kbeckmann/TR-9/kicad/Mainboard/Mainboard.kicad_pcb

## KiCad design kicad/Mainboard/Mainboard.kicad_pcb (2020-09-24)

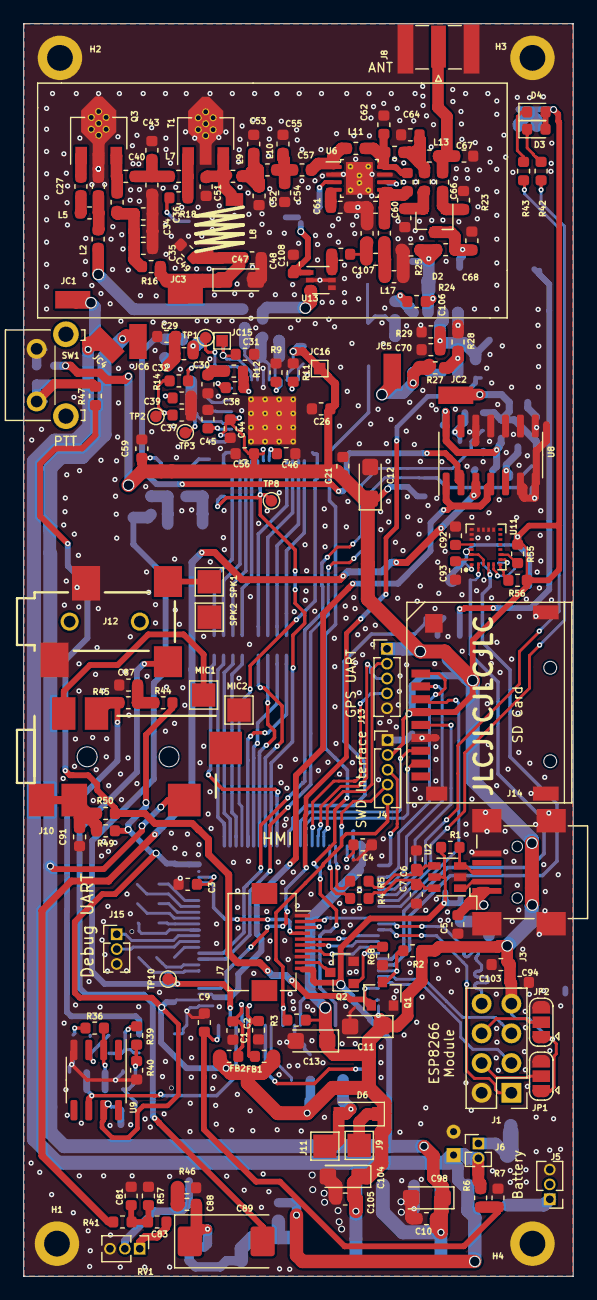
[picture p1: board Mainboard.kicad_pcb from above]

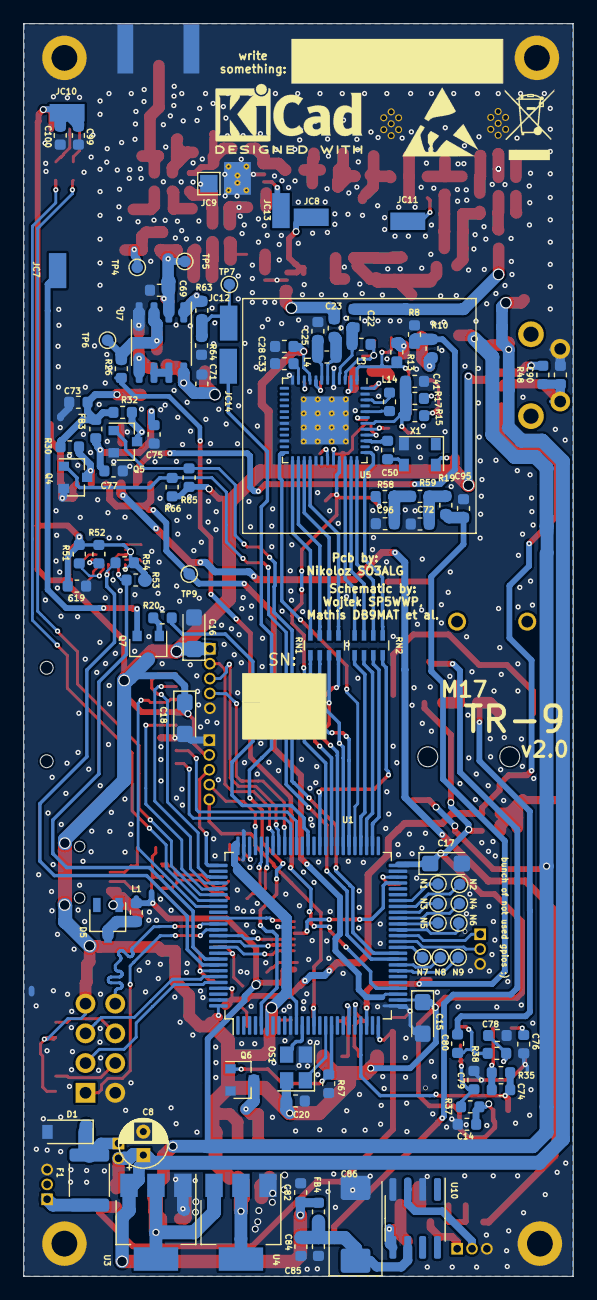
[picture p2: board Mainboard.kicad_pcb from below]

Board: 2 copper layers, 47.0 x 107.1 mm, 279 parts (105 on the bottom side), 177 nets.

Parts:
C1, C2, C10, C14, C19, C30, C32, C33, C45, C46, C77, C85, C90, C91, C93, C100, C103, C105: 100n; C_0603_1608Metric
C3, C4: 2u2; C_0603_1608Metric
C5, C9, C20, C26, C28, C31, C44, C56, C59, C70, C71, C73, C82, C92, C94: 10n; C_0603_1608Metric
C6, C7: 47p; C_0603_1608Metric
C8: 22u; CP_Radial_D4.0mm_P2.00mm
C11, C12, C13, C15, C16, C17, C18, C98, C104: 22u/TA; CP_EIA-3216-18_Kemet-A
C21, C27, C40: 220p; C_0603_1608Metric
C22, C42, C43, C51, C55, C106: 10p; C_0603_1608Metric
C23: 4p7; C_0603_1608Metric
C24, C25: 6p8; C_0603_1608Metric
C29: 2n2; C_0603_1608Metric
C34, C75, C80, C84, C99: 1u; C_0603_1608Metric
C35, C41, C68, C69: 1n; C_0603_1608Metric
C36, C49: 100p; C_0603_1608Metric
C37: 470p; C_0603_1608Metric
C38, C108: 22n; C_0603_1608Metric
C39, C81: 15n; C_0603_1608Metric
C47: 1u/TA; CP_EIA-3216-18_Kemet-A
C48, C57, C58, C63: 1000p; C_0603_1608Metric
C50: 22p; C_0603_1608Metric
C52, C62: 7p; C_0603_1608Metric
C53: 12p; C_0603_1608Metric
C54: 2p; C_0603_1608Metric
C60: 6p2; C_0603_1608Metric
C61: 33p; C_0603_1608Metric
C64, C67: 9p1; C_0603_1608Metric
C65, C66: 0.5p; C_0603_1608Metric
C72, C95, C96: 1n5; C_0603_1608Metric
C74, C88: 47n; C_0603_1608Metric
C76: 22u; C_0603_1608Metric
C78: 6n8; C_0603_1608Metric
C79, C87: 10u; C_0603_1608Metric
C83: 220n; C_0603_1608Metric
C86, C89: 220u; CP_EIA-7343-31_Kemet-D
C97: 8p2; C_0603_1608Metric
C107: 5p1; C_0603_1608Metric
D1, D6: CGRM4007-G; D_SOD-123
D2: BAS70-05; SOT-23
D3: RED; D_0603_1608Metric
D4: GREEN; D_0603_1608Metric
D5: PMEG4005ET.215
F1: 2A; Fuse_1812_4532Metric
FB1, FB2, FB3, FB4: TBD; L_0603_1608Metric
H1, H2, H3, H4: MountingHole_Pad; MountingHole_2.2mm_M2_ISO14580_Pad
J1: ESP8266 module; PinHeader_2x04_P2.54mm_Vertical
J3: USB_OTG; USB_Mini-B_Wuerth_65100516121_Horizontal
J4: SWD; PinHeader_1x05_P1.27mm_Vertical
J5: BATT; PinHeader_1x03_P1.27mm_Vertical
J6: POT_PWR_SW; PinHeader_1x02_P1.27mm_Vertical
J7: Conn_01x10; Hirose_FH12-10S-0.5SH_1x10-1MP_P0.50mm_Horizontal
J8: Antenna; SMA_Samtec_SMA-J-P-X-ST-EM1_EdgeMount
J9: VIB1; TestPoint_Pad_2.0x2.0mm
J10: MIC_EXT
J11: VIB2; TestPoint_Pad_2.0x2.0mm
J12: SPK_EXT
J13: GPS_CONN; PinHeader_1x05_P1.27mm_Vertical
J14: Micro_SD_Card; microSD
J15: DBG_CONN; PinHeader_1x03_P1.27mm_Vertical
JC1, JC2, JC3, JC4, JC6: Batt; Pad1x3
JC5: 5V; Pad1x3
JC7: LNA_1; Pad1x3
JC8: LNA_2; Pad1x3
JC9: TRX_SW_PWR_1; TestPoint_Pad_1.5x1.5mm
JC10: TRX_SW_PWR_2; Pad1x3
JC11, JC12: BIAS; Pad1x3
JC13, JC14: TRX_SW; Pad1x3
JC15, JC16: 3,3V; TestPoint_Pad_1.0x1.0mm
JP1: GPIO0; SolderJumper-3_P1.3mm_Open_RoundedPad1.0x1.5mm
JP2: GPIO2; SolderJumper-3_P1.3mm_Open_RoundedPad1.0x1.5mm
L1: 100MHz; L_0603_1608Metric
L2: 20n; L_0603_1608Metric
L3: 15n; L_0603_1608Metric
L4: 27n; L_0603_1608Metric
L5: 22n; L_0603_1608Metric
L6: 68nH; L_0603_1608Metric
L7: 2.7nH; L_0603_1608Metric
L8: 8/0.5/2.4; RF_Coil_v2_mirrored
L9, L10: 1nH; L_0603_1608Metric
L11: 100nH; L_0603_1608Metric
L12, L13: 15nH; L_0603_1608Metric
L14: DNP; L_0603_1608Metric
L16: 13nH; L_0603_1608Metric
L17: 20nH; L_0603_1608Metric
MIC1: Microphone pin 1; TestPoint_Pad_2.0x2.0mm
MIC2: Microphone pin 2; TestPoint_Pad_2.0x2.0mm
N1, N2, N3, N4, N5, N7, N8, N9: TP2; TestPoint_Pad_D1.0mm
N6: TP1; TestPoint_Pad_D1.0mm
OS1: ECS-3225MV-160-CN-TR; ECS-3225-MV-160-CN-TR
Q1, Q2, Q4, Q5, Q6: BSS138; SOT-23
Q3: BGA6589
Q7: FDV304P; SOT-23
R1: 1k5; R_0603_1608Metric
R2, R3, R25, R26, R29, R39, R48, R49, R51, R52, R55, R56: 10k; R_0603_1608Metric
R4, R5: 27; R_0603_1608Metric
R6: 9k1; R_0603_1608Metric
R7, R44: 1k; R_0603_1608Metric
R8, R41, R65, R66, R67, R68: 22k; R_0603_1608Metric
R9: 1k1; R_0603_1608Metric
R10, R13, R24, R27, R28, R30, R32, R37, R40: 47k; R_0603_1608Metric
R11: 3k6; R_0603_1608Metric
R12: 3R9; R_0603_1608Metric
R14: 100; R_0603_1608Metric
R15: 560; R_0603_1608Metric
R16: 51; R_0603_1608Metric
R17: 270; R_0603_1608Metric
R18, R38, R53, R54: 4k7; R_0603_1608Metric
R19, R58, R59, R63, R64: 5k6; R_0603_1608Metric
R20: ?; R_0603_1608Metric
R22, R23: 33k; R_0603_1608Metric
R35: 820; R_0603_1608Metric
R36: 22; R_0603_1608Metric
R42, R43, R47, R50: 470; R_0603_1608Metric
R45: 3k9; R_0603_1608Metric
R46: 10; R_0603_1608Metric
R57: 2k1; R_0603_1608Metric
RN1, RN2: 4 x 1k ISOLATED; R_Array_Concave_4x0603
RV1: 50k/log; PinHeader_1x03_P1.27mm_Vertical
SPK1: Speaker pin 1; TestPoint_Pad_2.0x2.0mm
SPK2: Speaker pin 2; TestPoint_Pad_2.0x2.0mm
SW1: INT_PTT_SW; SW_Tactile_SKHH_Angled
T1: AFT05MS004NT1
TP1, TP2, TP3, TP4, TP5, TP6, TP7, TP8, TP9, TP10: TestPoint_Probe; TestPoint_Pad_D1.0mm
U1: STM32F777VIT; LQFP-100_14x14mm_P0.5mm
U2: USBLC6-2SC6; SOT-23-6
U3: LD1117S50TR_SOT223; SOT-223-3_TabPin2
U4: LD1117S33TR_SOT223; SOT-223-3_TabPin2
U5: ADF7021; LFCSP-48-1EP_7x7mm_P0.5mm_EP4.1x4.1mm_ThermalVias
U6: HMC546MS8GETR
U7: LM2904A; SO-8_3.9x4.9mm_P1.27mm
U8: HEF4066B; SOIC-14_3.9x8.7mm_P1.27mm
U9: OPA340UA; SO-8_3.9x4.9mm_P1.27mm
U10: LM386; SOIC-8_3.9x4.9mm_P1.27mm
U11: LSM9DS1; LGA-24L_3x3.5mm_P0.43mm
U13: BGA2874; SOT-363_SC-70-6
X1: 12.288MHz; ECS-TXO-3225

Connections:
+3V3: C11.1, C12.1, C13.1, C14.1, C15.1, C16.1, C17.1, C18.1, C19.1, C20.2, C21.1, C26.1, C28.1, C31.1, C44.1, C56.1, C59.1, C94.1, C99.1, C100.1, C103.1, C104.1, C105.1, D3.2, D4.2, D6.1, FB1.2, FB2.2, J1.7, J4.2, J7.3, J9.1, J13.1, J14.4, JC9.1, JC10.1, JC15.1, JC16.1, JP1.1, JP2.1, L3.1, OS1.4, Q7.3, R2.2, R3.1, R37.2, R44.2, R48.1, R49.1, R51.1, R52.1, R53.1, R54.1, R55.1, R56.1, R65.2, R66.2, U1.6, U1.11, U1.27, U1.50, U1.75, U1.100, U4.2, U5.3, U5.9, U5.32, U5.40, U5.43, U6.6, U9.7, U11.1, U11.3, U11.22, U11.23, X1.4
+5V: C10.1, C71.1, C98.1, J7.10, J10.1, JC5.1, JC6.1, L1.1, R1.1, R27.2, U2.5, U3.2, U4.3, U7.8
+BATT: C8.1, C47.1, C48.2, C49.2, C73.1, C82.1, FB3.1, FB4.1, J6.2, JC1.1, JC2.1, JC3.1, JC4.1, L8.1, R6.1, R16.2, R30.1, R32.1, U3.3
ADC1_0: C74.2, R35.2, U1.22, U9.6
ADC2_3: C9.2, R6.2, R7.1, U1.25
ADC3_1: C95.2, R19.1, TP10.1, U1.23
ADF_CE: U1.55, U5.24
ADF_MUXOUT: RN2.8, U1.61
ADF_SCLK: RN1.8, U1.59
ADF_SDATA: RN1.6, U1.57
ADF_SLE: RN1.5, U1.56
ADF_SREAD: RN1.7, U1.58
ADF_SWD: R58.2, TP8.1, U1.60, U5.33
AUDIO_DAC: TP9.1, U1.28, U8.1, U8.4
BATT_ANALOG: C75.1, C77.1, FB3.2, U8.14
BLIGHT_CTRL: Q2.1, R68.1, U1.91
BOOT0: Q1.3, R2.1, U1.94
FM_MOD: R8.2, R10.1, U8.2
FM_MOD_SEL: Q5.1, R65.1, U1.35
GND: C1.2, C2.2, C3.1, C4.1, C5.1, C6.1, C7.1, C8.2, C9.1, C10.2, C11.2, C12.2, C13.2, C14.2, C15.2, C16.2, C17.2, C18.2, C19.2, C20.1, C21.2, C24.2, C25.2, C26.2, C28.2, C29.1, C30.2, C31.2, C33.2, C34.2, C35.2, C36.2, C37.2, C39.2, C41.2, C42.2, C43.2, C44.2, C45.2, C46.1, C47.2, C48.1, C49.1, C51.2, C52.1, C53.2, C54.1, C55.2, C56.2, C59.2, C60.1, C61.2, C62.1, C64.1, C67.1, C68.2, C69.2, C70.2, C71.2, C72.1, C73.2, C75.2, C76.2, C77.2, C78.2, C79.1, C81.2, C82.2, C84.2, C85.2, C86.2, C87.1, C90.1, C91.1, C92.2, C93.2, C94.2, C95.1, C96.1, C98.2, C99.2, C100.2, C103.2, C104.2, C105.2, C108.2, D1.2, H1.1, H2.1, H3.1, H4.1, J1.2, J3.5, J3.6, J4.1, J5.3, J7.1, J7.8, J8.2, J12.2, J13.5, J14.6, J14.9, J15.3, JP1.3, JP2.3, L16.2, L17.2, MIC2.1, OS1.2, Q1.2, Q2.2, Q3.2, Q4.2, Q5.2, Q6.2, R7.2, R8.1, R9.2, R11.2, R22.1, R23.1, R25.1, R28.1, R29.1, R40.1, R46.1, R57.2, R64.2, R67.2, R68.2, RV1.3, SPK2.1, SW1.2, T1.S, U1.10, U1.19, U1.26, U1.49, U1.74, U1.99, U2.2, U3.1, U4.1, U5.5, U5.12, U5.19, U5.22, U5.29, U5.45, U5.47, U5.49, U6.2, U6.7, U6.EP, U7.4, U8.6, U8.7, U8.8, U8.9, U8.10, U8.11, U8.12, U9.4, U10.2, U10.4, U11.14, U11.15, U11.16, U11.17, U11.18, U11.19, U11.20, U13.2, U13.4, U13.5, X1.2
GPS_EN: J13.4, U1.67
I2C1_SCL: R53.2, U1.92, U11.2
I2C1_SDA: R54.2, U1.93, U11.4
LED_GRN: R43.2, U1.81
LED_RED: R42.2, U1.82
LNA_On: R20.1, U1.63
MIC_AMP_IN: C80.1, J10.2, R45.1
NRST: J4.5, R3.2, U1.14
unnamed: C3.2, U1.48
unnamed: C4.2, U1.73
unnamed: C5.2, D5.2, J3.1
unnamed: C6.2, R5.2, U2.4
unnamed: C7.2, R4.2, U2.6
unnamed: C22.2, L3.2, U5.4
unnamed: C23.2, L4.1, U5.6
unnamed: C24.1, L2.2, L5.1
unnamed: C25.1, L4.2, U5.7
unnamed: C27.1, Q3.3
unnamed: C27.2, L5.2
unnamed: C29.2, C32.2, R10.2
unnamed: C30.1, R12.2
unnamed: C32.1, R13.2
unnamed: C33.1, U5.11
unnamed: C34.1, C35.1, C36.1, L6.1, R16.1
unnamed: C37.1, R14.1, R15.2, TP2.1
unnamed: C38.1, U5.48
unnamed: C38.2, R12.1, U5.2
unnamed: C39.1, R17.2
unnamed: C40.1, C42.1, C43.1, L7.1
unnamed: C40.2, L6.2, Q3.1
unnamed: C41.1, R15.1, R17.1, TP3.1, U5.42
unnamed: C45.1, U5.41
unnamed: C46.2, U5.31
unnamed: C50.1, U5.39
unnamed: C50.2, X1.3
unnamed: C51.1, L8.2, L9.1, T1.D
unnamed: C52.2, C53.1, L9.2, L10.1
unnamed: C54.2, C55.1, C57.2, L10.2
unnamed: C57.1, L11.1, U6.1
unnamed: C58.1, C60.2, L12.1, U6.5
unnamed: C61.1, U6.4
unnamed: C62.2, C63.2, L11.2, L12.2, U6.8
unnamed: C63.1, C64.2, C65.2, L13.1
unnamed: C65.1, D2.2, R22.2
unnamed: C66.1, D2.1, R23.2
unnamed: C66.2, C67.2, J8.1, L13.2
unnamed: C68.1, D2.3, R24.2, TP4.1
unnamed: C70.1, R26.1, R29.2, TP6.1, U7.3
unnamed: C72.2, R19.2, R59.1
unnamed: C74.1, R35.1, R36.1, U9.2
unnamed: C76.1, R36.2
unnamed: C78.1, R38.2, U9.3
unnamed: C79.2, R37.1, R39.2, R40.2
unnamed: C80.2, R38.1, R39.1
unnamed: C81.1, C83.1, R41.1, R57.1
unnamed: C83.2, RV1.1
unnamed: C84.1, C85.1, C86.1, FB4.2, U10.6
unnamed: C87.2, R44.1, R45.2
unnamed: C88.1, R46.2
unnamed: C88.2, C89.1, U10.5
unnamed: C89.2, J12.1
unnamed: C90.2, R47.1, R48.2, SW1.1
unnamed: C91.2, J10.3, R49.2, R50.2
unnamed: C92.1, U11.21
unnamed: C93.1, U11.24
unnamed: C96.2, R58.1, R59.2
unnamed: C97.1, U13.6
unnamed: C106.1, R63.1, U7.1
unnamed: C69.1, C106.2, R24.1, R25.2, TP5.1, U7.2
unnamed: C97.2, C107.1, L16.1
unnamed: C58.2, C107.2, L17.1
unnamed: C108.1, JC7.1, JC8.1, Q7.2, U13.1
unnamed: D1.1, F1.2, J6.1
unnamed: D3.1, R42.1
unnamed: D4.1, R43.1
unnamed: D5.1, L1.2
unnamed: D6.2, J11.1, Q6.3
unnamed: F1.1, J5.1
unnamed: J1.4, JP1.2
unnamed: J1.6, JP2.2
unnamed: J3.2, U2.1
unnamed: J3.3, R1.2, U2.3
unnamed: J10.5, MIC1.1
unnamed: J12.3, SPK1.1
unnamed: JC11.1, JC12.1, R18.1, R63.2, R64.1, TP7.1
unnamed: L14.1, U5.46
unnamed: L14.2, U5.44
unnamed: N1.1, U1.44
unnamed: N2.1, U1.43
unnamed: N3.1, U1.42
unnamed: N4.1, U1.41
unnamed: N5.1, U1.40
unnamed: N6.1, U1.39
unnamed: N7.1, U1.36
unnamed: N8.1, U1.33
unnamed: N9.1, U1.32
unnamed: OS1.3, U1.12
unnamed: Q4.3, R30.2, U8.5
unnamed: Q5.3, R32.2, U8.13
unnamed: Q7.1, R20.2
unnamed: R9.1, U5.8
unnamed: R11.1, U5.10
unnamed: R13.1, R14.2, TP1.1, U5.1
unnamed: R27.1, R28.2, U7.5
unnamed: R51.2, U11.5
unnamed: R52.2, U11.7
unnamed: R55.2, U11.8
unnamed: R56.2, U11.6
unnamed: RN1.1, U5.28
unnamed: RN1.2, U5.27
unnamed: RN1.3, U5.26
unnamed: RN1.4, U5.25
unnamed: RN2.1, U5.37
unnamed: RN2.2, U5.36
unnamed: RN2.3, U5.35
unnamed: RN2.4, U5.34
unnamed: RV1.2, U10.3
unnamed: U7.6, U7.7
PA_BIAS: L7.2, R18.2, T1.G
PA_RAMP: R26.2, U1.29
PTT: Q1.1, R47.2, R50.1, U1.97
RX: C23.1, U13.3
SD_CLK: J14.5, U1.80
SD_CMD: J14.3, U1.83
SD_D0: J14.7, U1.65
SD_D1: J14.8, U1.66
SD_D2: J14.1, U1.78
SD_D3: J14.2, U1.79
SPI1_CS: J7.7, U1.90
SPI1_MOSI: J7.5, U1.88
SPI1_SCK: J7.6, U1.89
SPI2_MISO: RN2.6, U1.53
SPI2_MOSI: RN2.5, U1.54
SPI2_SCK: RN2.7, U1.52
SPK_AMP: R41.2, U8.3
SPK_AMP_SEL: Q4.1, R66.1, U1.34
SWCLK: J4.3, U1.76
SWDIO: J4.4, U1.72
TFT_LED: J7.9, Q2.3
TFT_RST: J7.2, U1.85
TRX_SW: JC13.1, JC14.1, U1.5, U6.3
TX: C22.1, L2.1
UART1_RX: J13.2, U1.69
UART1_TX: J13.3, U1.68
UART2_RX: J1.1, U1.87
UART2_TX: J1.8, U1.86
UART3_RX: J7.4, U1.47
UART7_RX: J15.2, U1.37
UART7_TX: J15.1, U1.38
USBDM: R4.1, U1.70
USBDP: R5.1, U1.71
VDDA: C1.1, FB2.1, U1.21
VIBRATE: Q6.1, R67.1, U1.17
VREF: C2.1, FB1.1, U1.20
WIFI_EN: J1.3, U1.96
WIFI_RST: J1.5, U1.95
XO_EN: OS1.1, U1.16
